JopMolenaar/IoT-check-in-project/README.md

# IoT 

[Link my learnings and docs](https://iot.dev.hihva.nl/2023-2024-semester-1/individual-project/iot-molenaj20/)
