JopMolenaar/IoT-check-in-project/docs/index.md

# Time registration

<!-- Describe the purpose of your blueprint. Design a nice front-page image that will describe your product. -->

For my minor IoT I have to make a propuct based on a blueprint that has sensors, uses data, data visualisation and many more things to give something usefull to the user. There where some topics that I had to chose from and I have chosen for the topic "time registration". I made a device that that tracks your shift times for a company. The employee has to check in and out when he/she is starting or ending the shift. If you want to get a break you simply push the button on the device and scan your card. And you do the same when you get back from your break. The oled screen on the device shows some text and the LED's above the oled show the status of your check in/out.

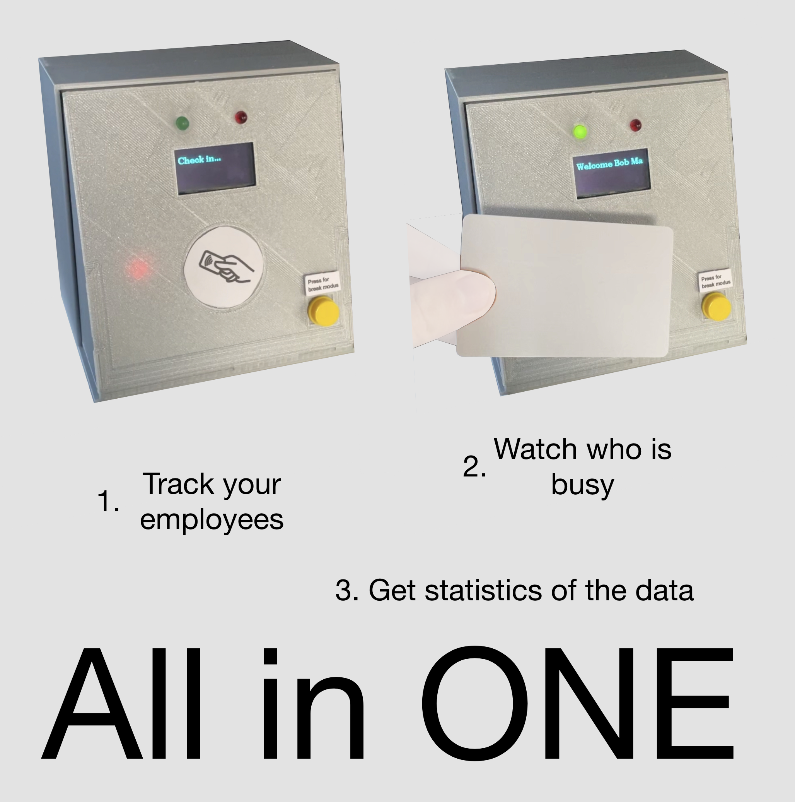
[picture p23: docs/assets/productPoster.png]


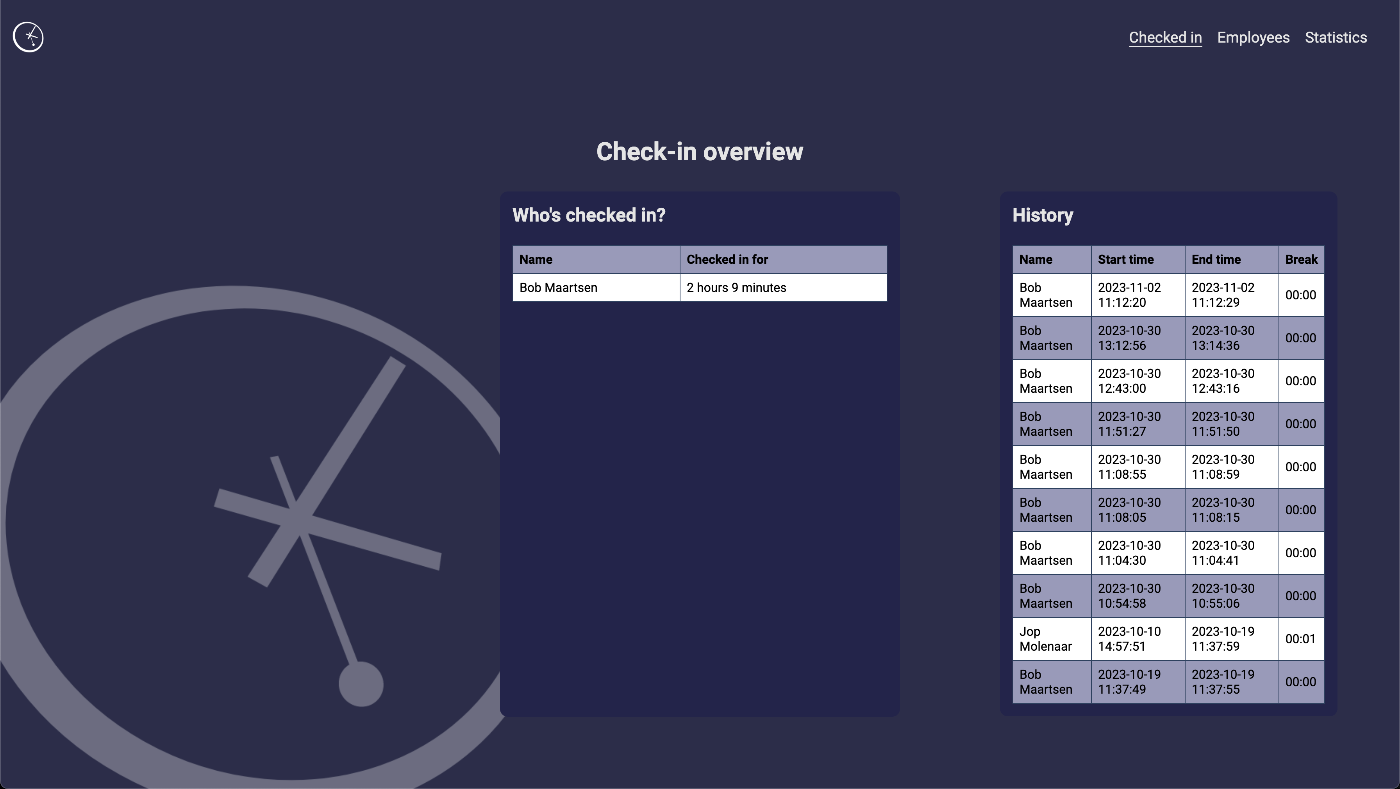
[picture p24: docs/assets/checkInPage.png]

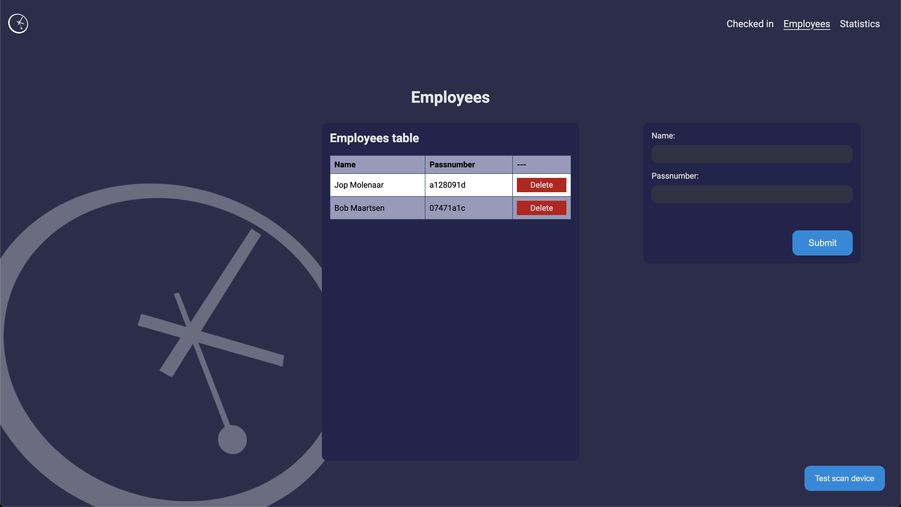
[picture p25: docs/assets/userPage.png]

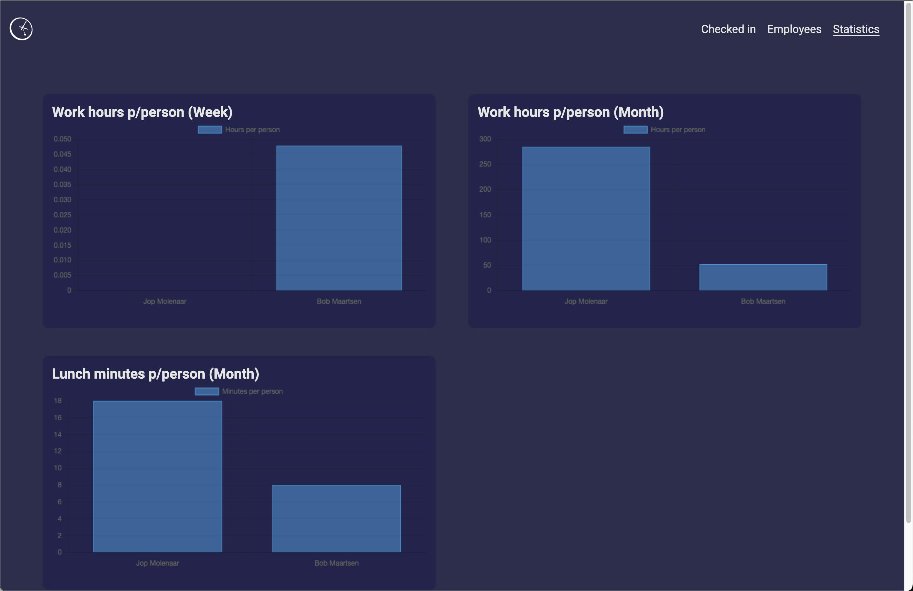
[picture p26: docs/assets/graphsPage.png]


{{ mdocotion_header('https://images.unsplash.com/photo-1550745165-9bc0b252726f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') }}
