JopMolenaar/IoT-check-in-project/docs/planning.md

# Planning

| Week | Start date | Activity |
| ---- | --- | --- |
| 1 | 4 sep | Bootcamp-week |
| 2 | 11 sep | Exploring embedded + working on the website **FE and BE**. **Fritzing prototype** and **little concept design** |
| 3 | 18 sep | Finishing embedded and web to communicate, **API** + **MySQL Workbench diagram database** |
| 4 | 25 sep | **System Architecture Diagram** and starting with making the **physical design** and making **BOM** |
| 5 | 2 oct | making a **physical design**, finishing **System Architecture Diagram** |
| 6 | 9 oct | Market research |
| 7 | 16 oct | Market research |
| 8 | 23 oct | Autumn break |
| 9 | 30 oct | Product market + improvements |
| 10 | 6 nov | Decision Committee |
| 11 | 4 dec | Resit deadline |

Tasks:

- Fritzing prototype
- FE and BE
- API reference
- BOM
- System Architecture Diagram
- MySQL Workbench diagram database
- Requirements embedded device
- Little concept design
- Making a physical design
