JopMolenaar/IoT-check-in-project/docs/embedded/code.md

# Embedded code

<!-- This is not a place to put your code, but to describe the code that you have written. You can describe the code in a general way, but also go into detail on specific parts of the code. You can also refer to the code in your repository. So just add a link to the code in your repository. -->

The code structure:

- Includes libaries that are needed.
- Connects to wifi.
- Has functions for shining LED's (some in a loop)
- Has functions for displaying text on the OLED
- The function loop is the main function to check if you scan a card and look if you pushed the button whay you did that. It also waits for incoming requests from the website.
- If you scanned the card it will send data to the API. The API sends a status back and the C++ code will execute some functions based on that status.

<a href="https://gitlab.fdmci.hva.nl/IoT/2023-2024-semester-1/individual-project/iot-molenaj20/-/blob/main/embedded/checkInOutWithCard/checkInCheckOut.ino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">Link to the code</a>

Some little explaination of part of the code:

This fires when you scan a card:

```cpp
  // Get and print cardId
  Serial.print(F("Card UID:"));
  dump_byte_array(mfrc522.uid.uidByte, mfrc522.uid.size);
  String concatenatedValue = concatenate_byte_array(mfrc522.uid.uidByte, mfrc522.uid.size);
  Serial.println();
  String cardId = concatenatedValue;

  // Read the button state every time a card is scanned
  buttonState = digitalRead(buttonCheckIn);

  // fire the function en say if the button is pressed or not
  if (buttonState == HIGH) {
    Serial.println("Button pressed");  // Button pressed for getting a break
    gettingBreak = true;
    displayTextOnOled("Loading...");
    sendToApi(gettingBreak, cardId);
  } else {
    Serial.println("Button not pressed");
    gettingBreak = false;
    displayTextOnOled("Loading...");
    sendToApi(gettingBreak, cardId);
  }
```

In the code above you see lines which are fired when you scan your card. The frist part gets the cardId of the card you scanned. After that it looks if the button is pressed or not when you scan your card. It changes the value of the variable **gettingBreak** and runs a function which changes the content on the oled to show the user he/she scanned his/her card. After that a function runs with the variable **gettingBreak** and the **cardId** of the card he/she scanned as parameters.

sendToApi(gettingBreak, cardId); is a function which sends this data to the API and gets a respond.
Dependent on what respond it gets, it will run various functions to show feedback to the user such as text on the oled screen and a status from the green and red LED's.

In the loop function it will also wait for incoming requests from the website. If you click the test button on the website it will run a test on the OLED and LED's.

```cpp
WiFiClient client = server.available();  // Listen for incoming clients

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

            if (header.indexOf("GET /test") >= 0) {
              Serial.println("test");
              displayTextOnOled("Testing...");
              interactionLed(ledGreen, blinkFrequencyLong, littleDelay);
              interactionLed(ledRed, blinkFrequencyLong, littleDelay);
              interactionLed(ledGreen, blinkFrequencyLong, littleDelay);
              interactionLed(ledRed, blinkFrequencyLong, littleDelay);
            }
            break;
          } else {  // if you got a newline, then clear currentLine
            currentLine = "";
          }
        } else if (c != '\r') {  // if you got anything else but a carriage return character,
          currentLine += c;      // add it to the end of the currentLine
        }
      }
    }
    // Clear the header variable
    header = "";
    // Close the connection
    client.stop();
    Serial.println("Client disconnected.");
    Serial.println("");
  }
```
