JopMolenaar/IoT-check-in-project/docs/assets/firstStageDesign.png

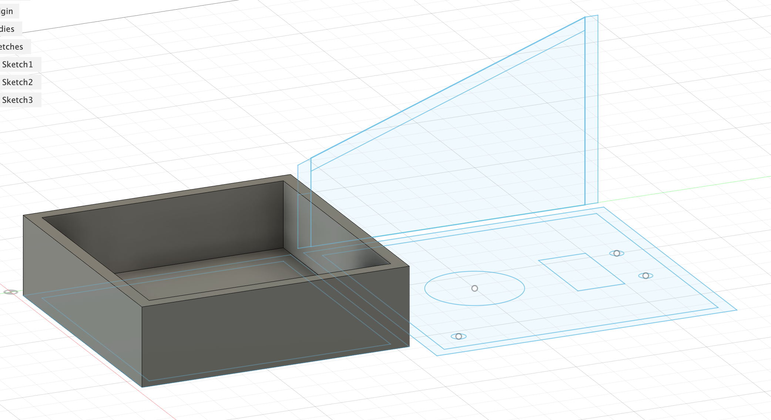
docs/assets/firstStageDesign.png
