JopMolenaar/IoT-check-in-project/docs/assets/lastStageDesign.png

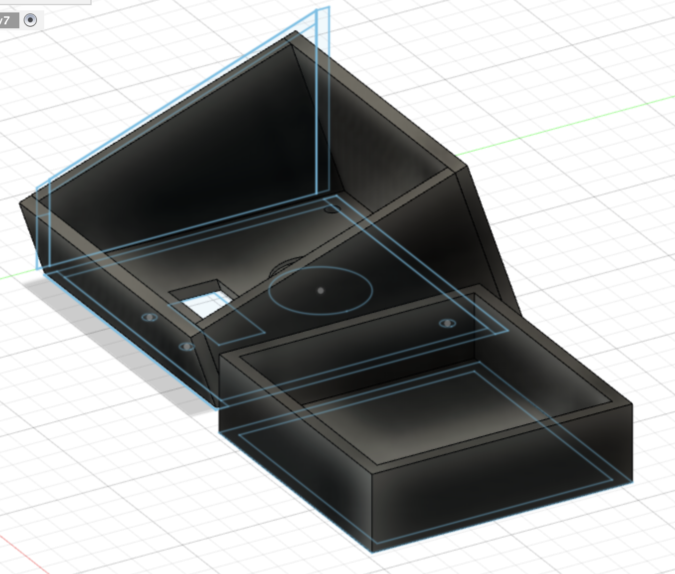
docs/assets/lastStageDesign.png
