JopMolenaar/IoT-check-in-project/docs/assets/middleStageDesign.png

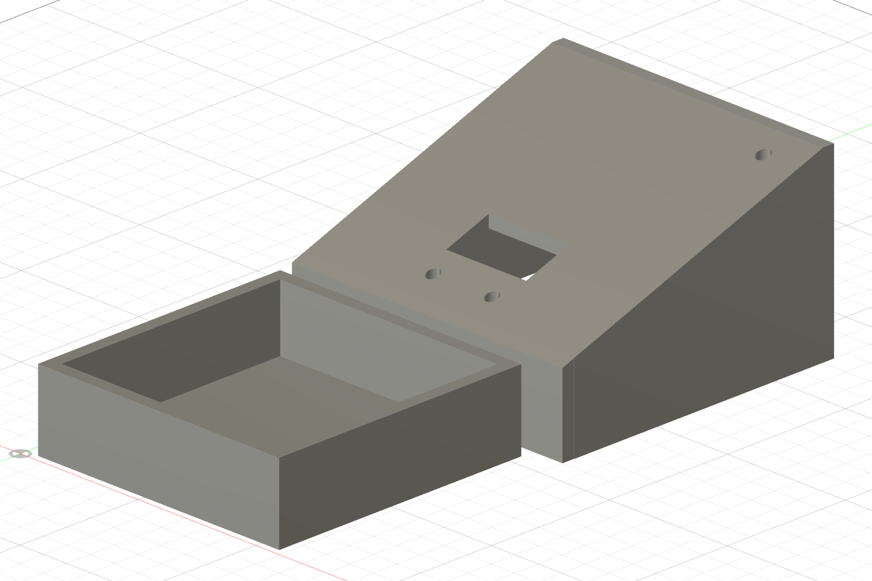
docs/assets/middleStageDesign.png
