JopMolenaar/IoT-check-in-project/docs/assets/mysqldiagram.png

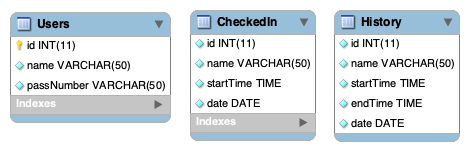
docs/assets/mysqldiagram.png
