JopMolenaar/IoT-check-in-project/docs/assets/productHomePage.png

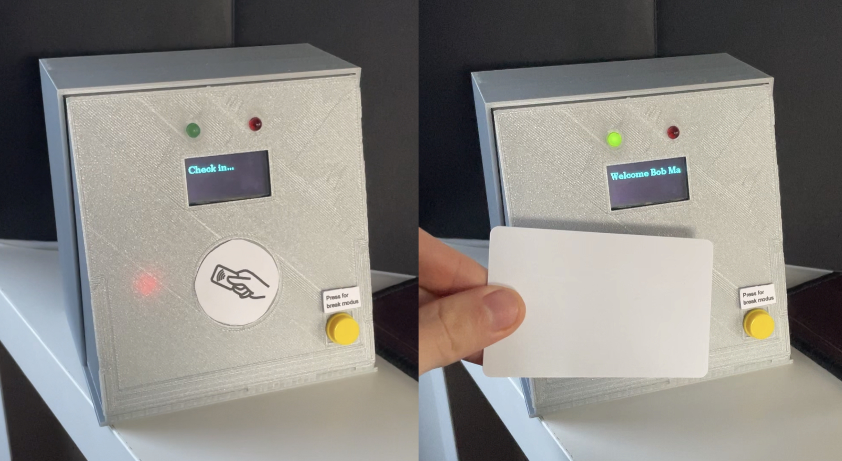
docs/assets/productHomePage.png
