JopMolenaar/IoT-check-in-project/docs/assets/systemDiagram.png

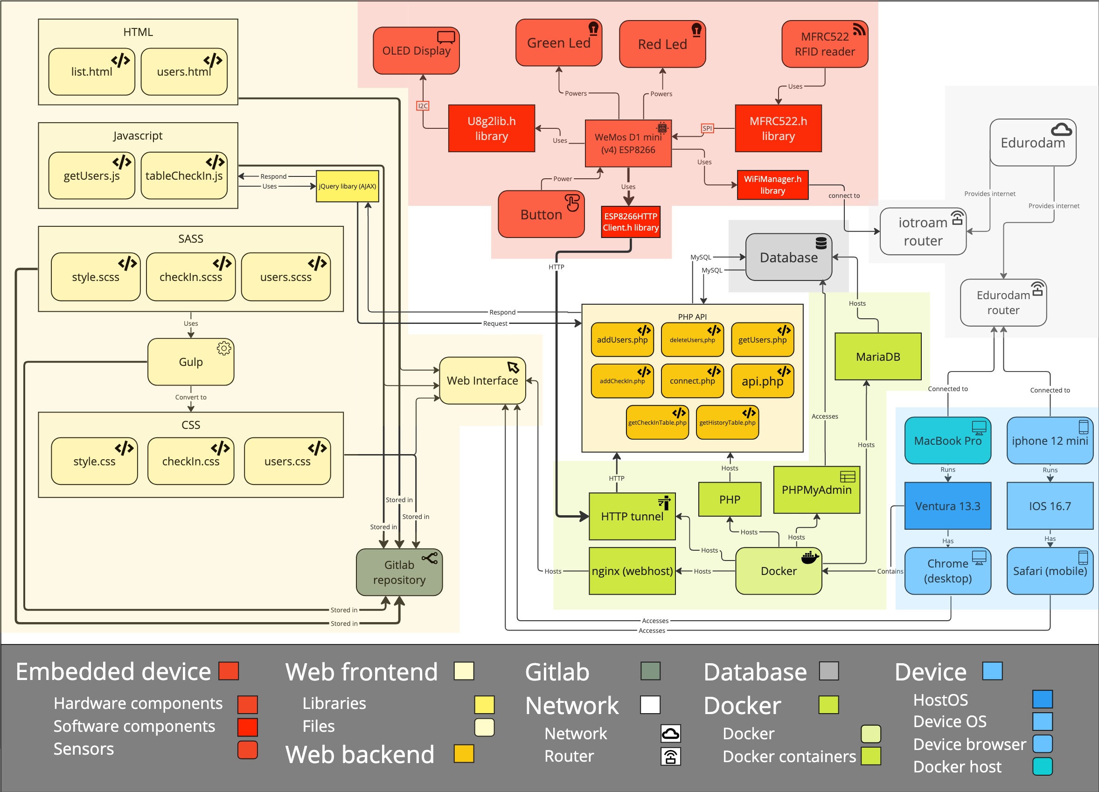
docs/assets/systemDiagram.png
