JopMolenaar/IoT-check-in-project/docs/assets/twoMagnets.png

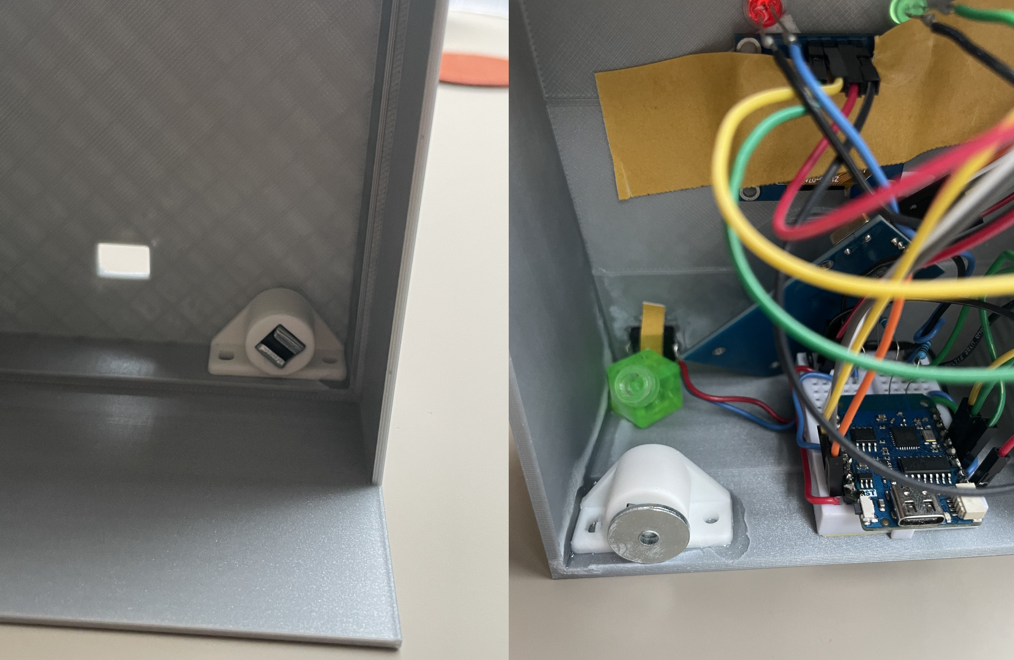
docs/assets/twoMagnets.png
