JopMolenaar/IoT-check-in-project/designFiles/backSideDesignFiles/part2JopIoT.step

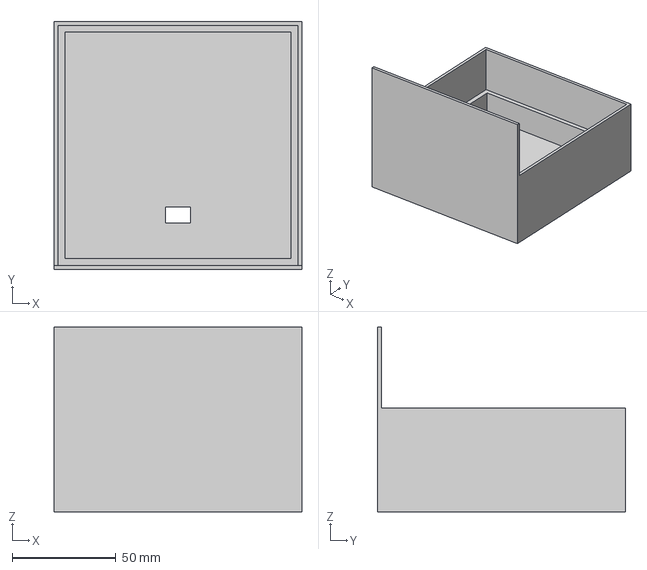
[picture p37: CAD file, 2024-03-03]
designFiles/backSideDesignFiles/part2JopIoT.step
119.5 x 119.5 x 89.0 mm
