JopMolenaar/IoT-check-in-project/designFiles/frontSideDesignFiles/physicalDesignIOTJopPart1.stl

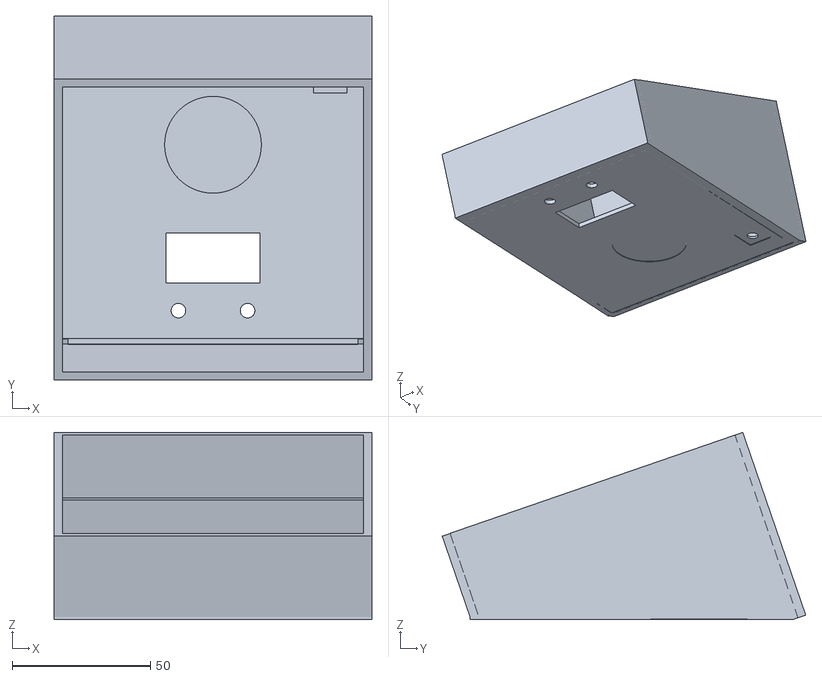
[picture p38: CAD file, 2024-03-03]
designFiles/frontSideDesignFiles/physicalDesignIOTJopPart1.stl
115.0 x 131.5 x 67.7
