JopMolenaar/IoT-check-in-project/(list of files, cad)

Other CAD files:
designFiles/frontSideDesignFiles/physicalDesignIOT.step
designFiles/backSideDesignFiles/part2JopIoT.stl
