JopMolenaar/IoT-check-in-project/docs/assets/backviewTestPrint.png

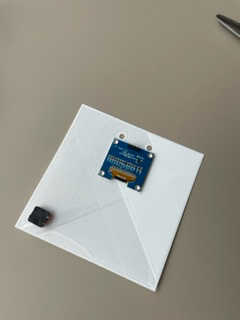
docs/assets/backviewTestPrint.png
