JopMolenaar/IoT-check-in-project/docs/assets/halfPrintTest.png

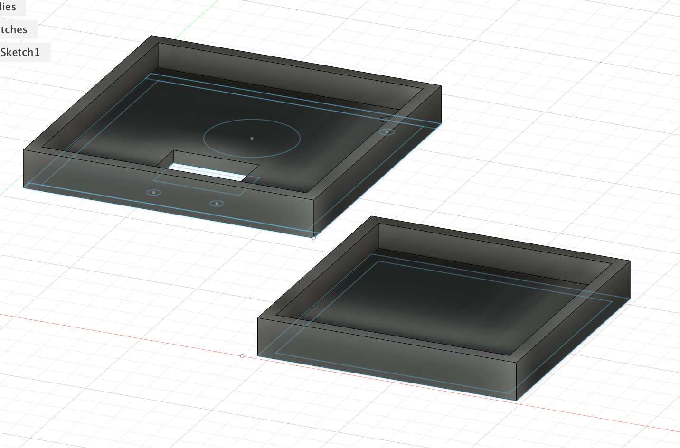
docs/assets/halfPrintTest.png
