JopMolenaar/IoT-check-in-project/docs/assets/printTest.png

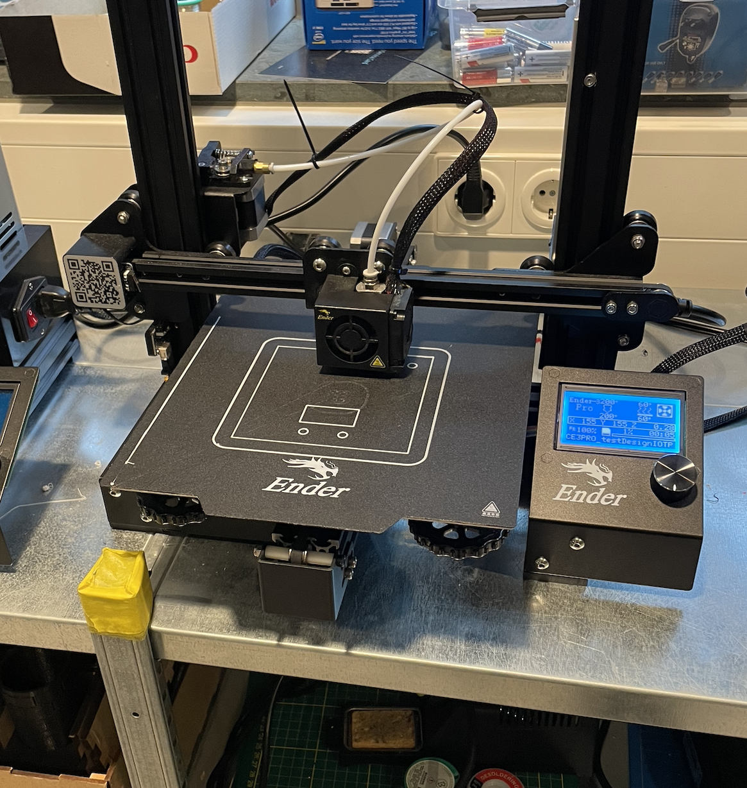
docs/assets/printTest.png
