JopMolenaar/IoT-check-in-project/docs/assets/greenDice.png

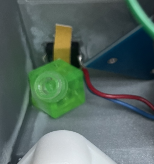
[picture p52: docs/assets/greenDice.png]
